skribascode/Moretti-pellet-stove-esp32/hardware/enclosure/enclosure_v3_lid.stl

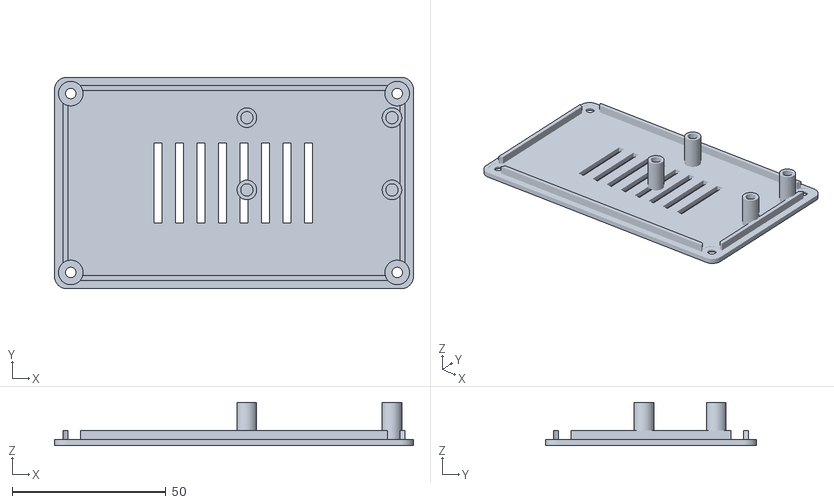
[picture p7: CAD file, 2026-11-11]
hardware/enclosure/enclosure_v3_lid.stl
116.8 x 68.8 x 14.1
