skribascode/Moretti-pellet-stove-esp32/hardware/enclosure/enclosure_v3_box.stl

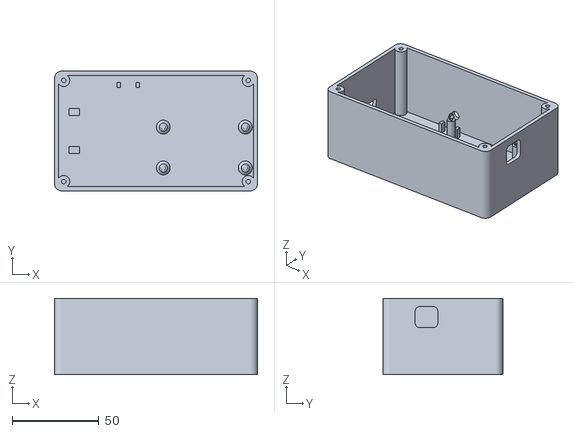
[picture p8: CAD file, 2026-11-11]
hardware/enclosure/enclosure_v3_box.stl
116.8 x 68.8 x 44.0
