skribascode/Moretti-pellet-stove-esp32/(commit log)

2026-11-11 Micronova pellet stove: ESPHome + Home Assistant + Lovelace card
    - ESPHome config for the micronova component (+ optional BLE proxy)
    - 3x PC817 interface schematic and point-to-point wire list
    - Technician menu step to enable remote control on the stove
    - Parametric 3D-printed enclosure (v3.1) with STL files
    - Home Assistant package: helpers, schedule, thermostat automation
    - poele-card: animated Lovelace card
    - README in English and French, liability section
    Claude-Session: https://claude.ai/code/session_01NZot8HnxZUpDxiP2YTQAkM
    [enclosure_v3_box.stl, enclosure_v3_lid.stl]
2026-11-11 README: product links in the bill of materials
    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
2026-11-11 README: remote access use case
    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
2026-11-14 Fix stove kept running after ESP reconnections; passive BLE scan
    The 30/45 min anti short-cycle timers used switch.poele_poele last_changed,
    which resets every time the ESP reconnects (unavailable -> on). With a few
    Wi-Fi drops the "running for 45 min" condition was never met and the stove
    kept heating outside the time slot.
    - package: input_datetime + poele_memo_bascule automation recording real
    off/on changes only; depuis_min now reads it
    - esphome: passive BLE scan (active scan made the ESP drop off Wi-Fi)
    - README: helper table, troubleshooting entry, BLE note (EN/FR)
    Claude-Session: https://claude.ai/code/session_01NZot8HnxZUpD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
