skribascode/Moretti-pellet-stove-esp32/(notices)

Notices in the files:
README.md:
License: MIT
